owlhawk/modular-test-system/hardware/controllers/STM32_controller/daq_controller.pdf

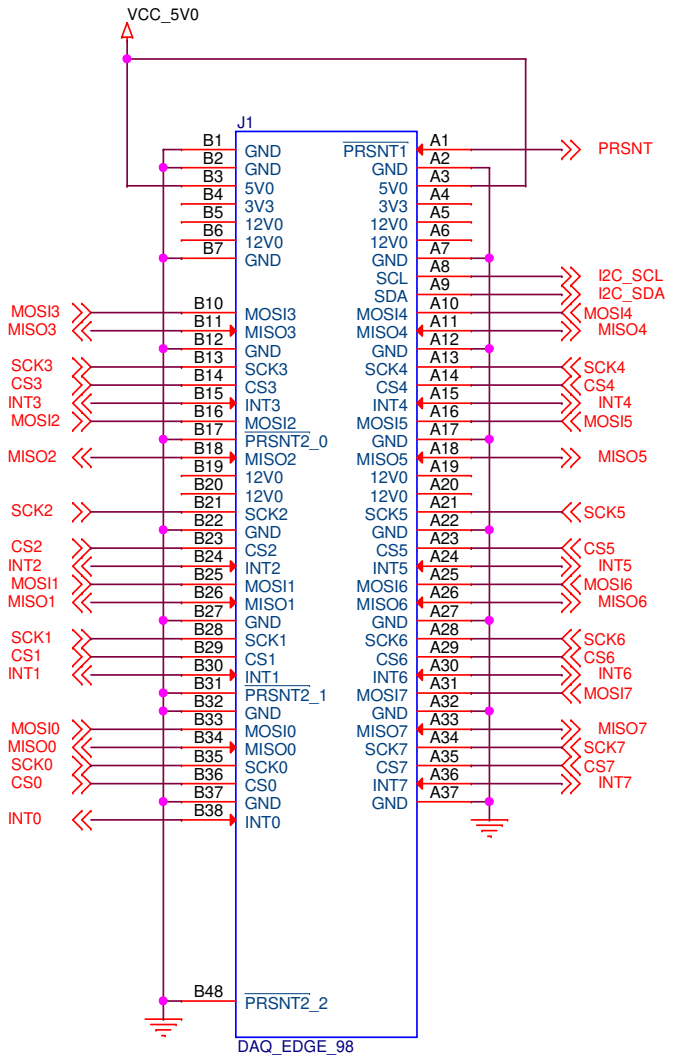
[picture p3: page 1]
VCC_5V0; MISO3; INT3; MISO2; MISO1; INT2; INT1; MISO0; INT0; MISO4; INT4; MISO5; INT5; MISO6; INT6; MISO7; INT7; MOSI3; MOSI4; SCK4 CS4; MOSI5; SCK5; MOSI6; SCK6 CS6; MOSI7; SCK7 CS7; SCK3 CS3; MOSI2; SCK2; MOSI1; SCK1 CS1; MOSI0; SCK0 CS0; PRSNT; I2C_SCL I2C_SDA; Title; Size; Document Number; Rev; Date:; Sheet; <Doc>; Card connector; Custom; Thursday, August 20, 2020; DAQ_EDGE_98; GND B1 GND B2 5V0 B3 3V3 B4 12V0 B5 12V0 B6 GND B7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

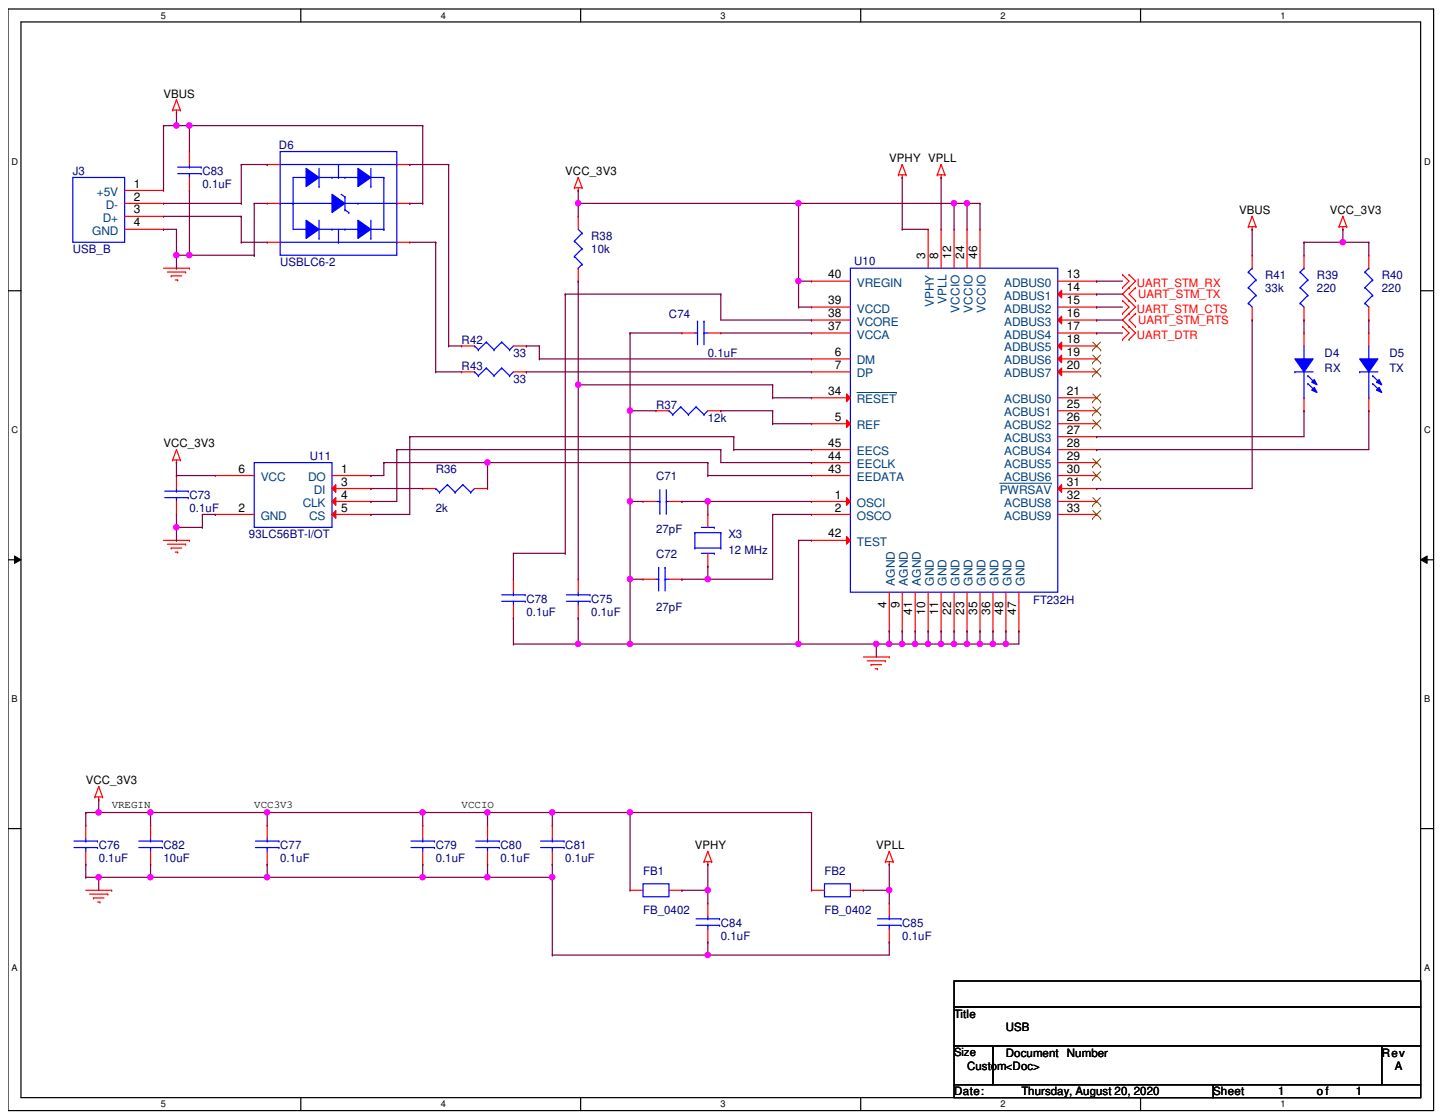
[picture p4: page 2]

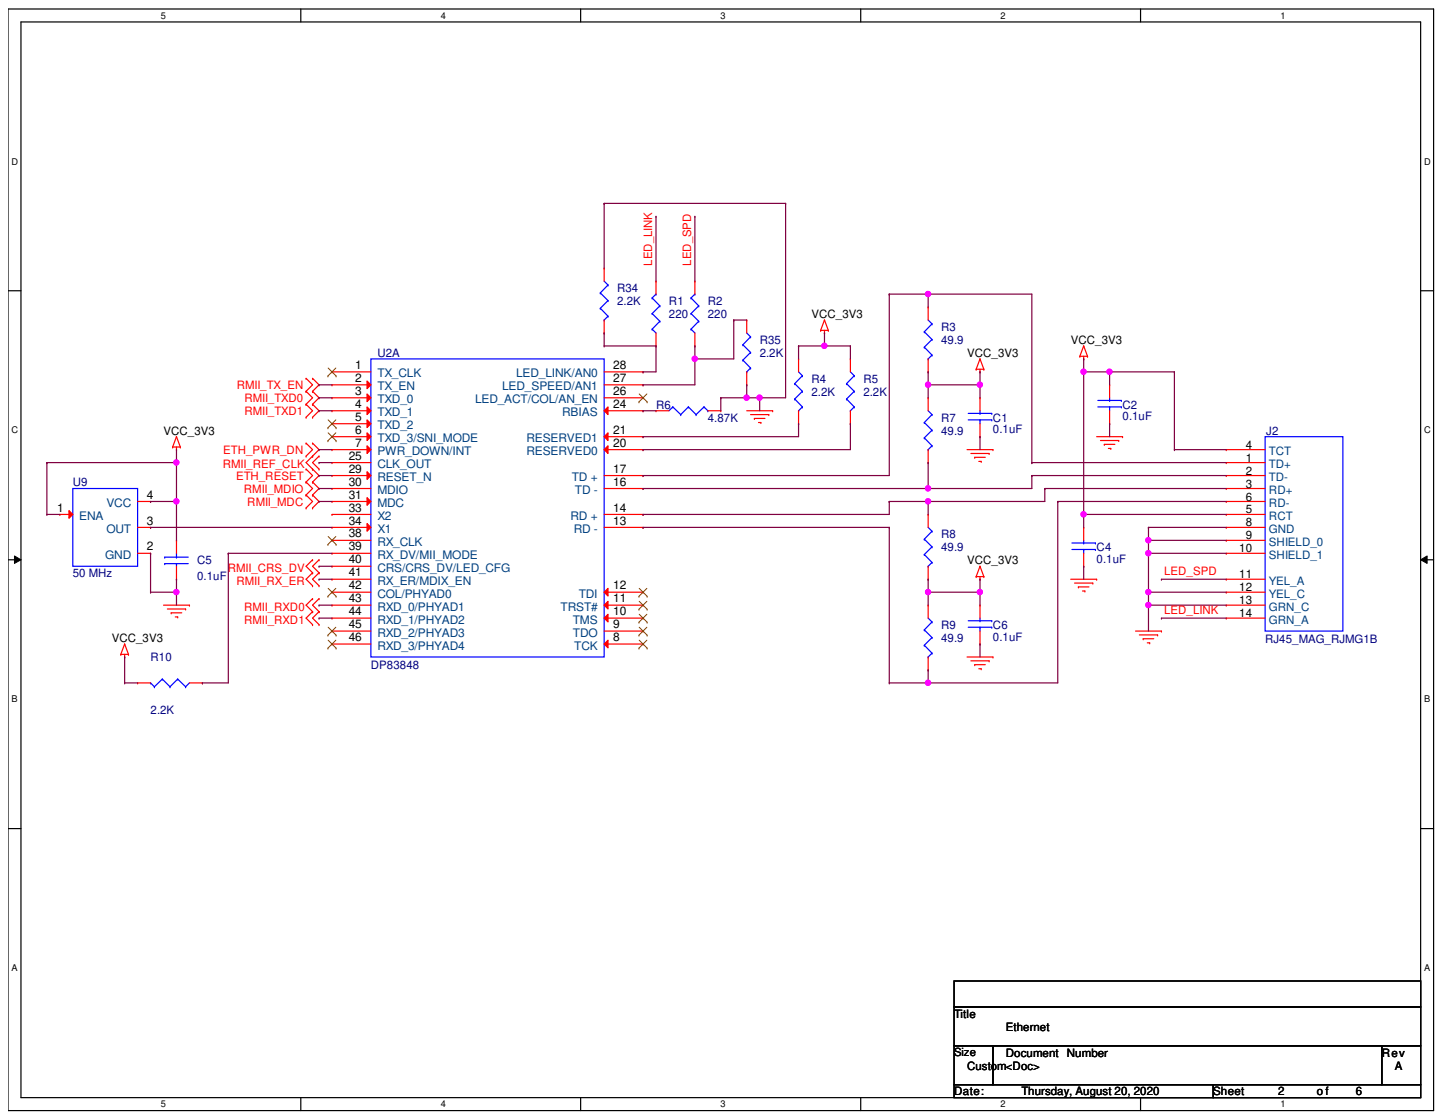
[picture p5: page 3]

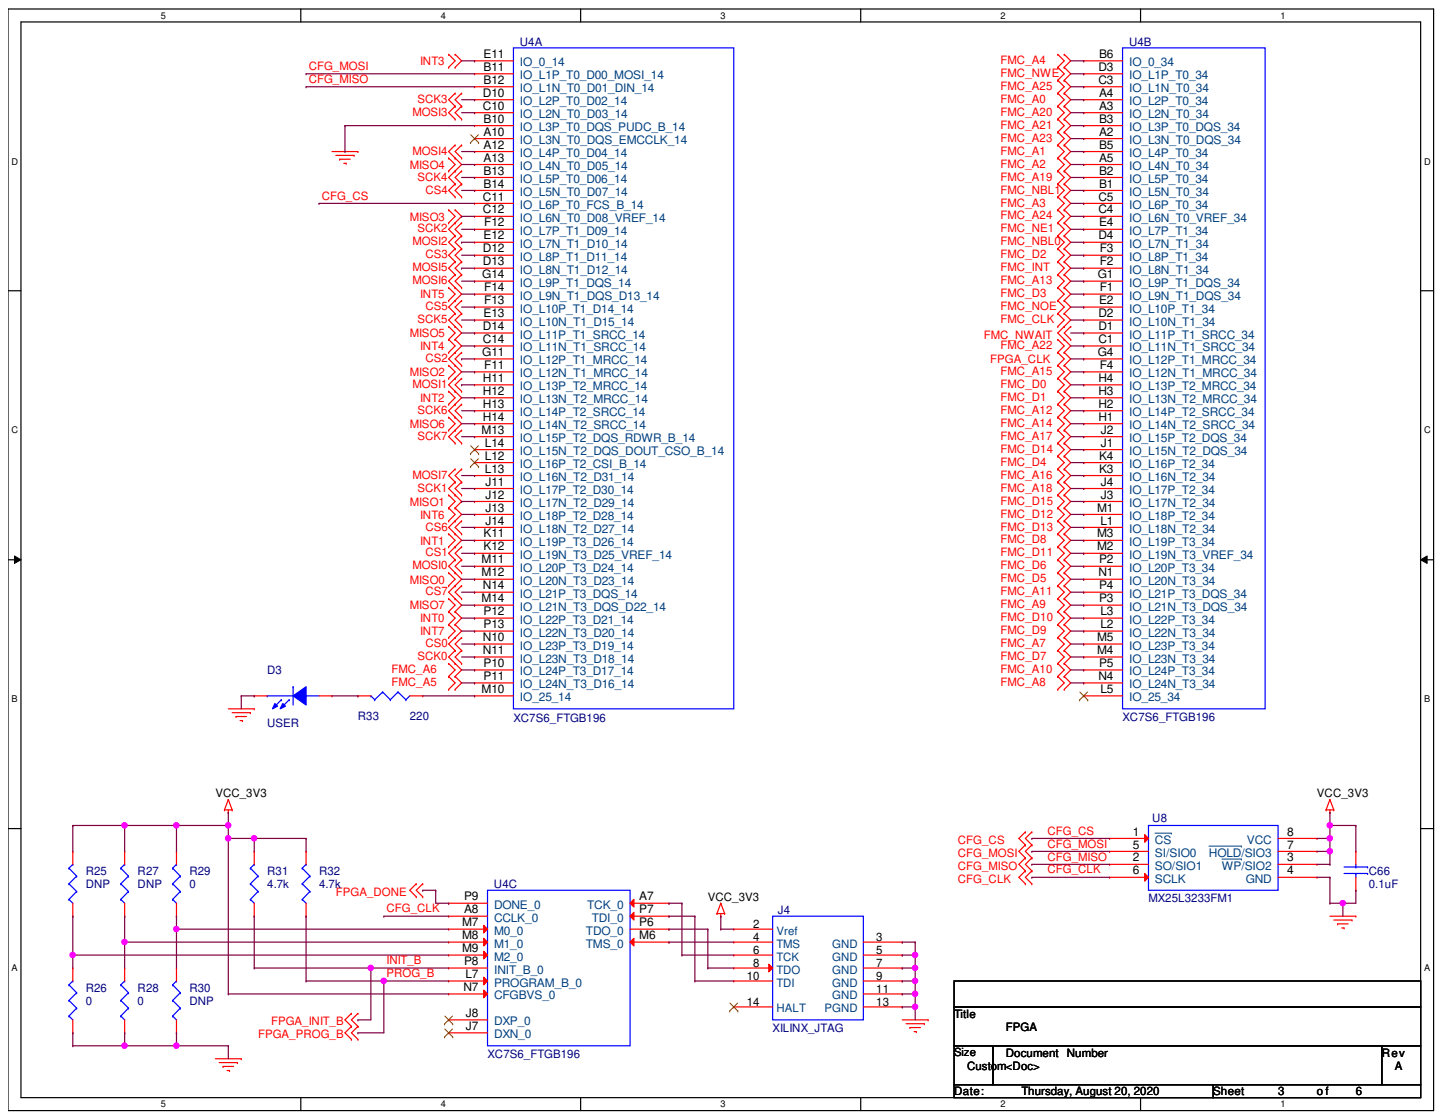
[picture p6: page 4]

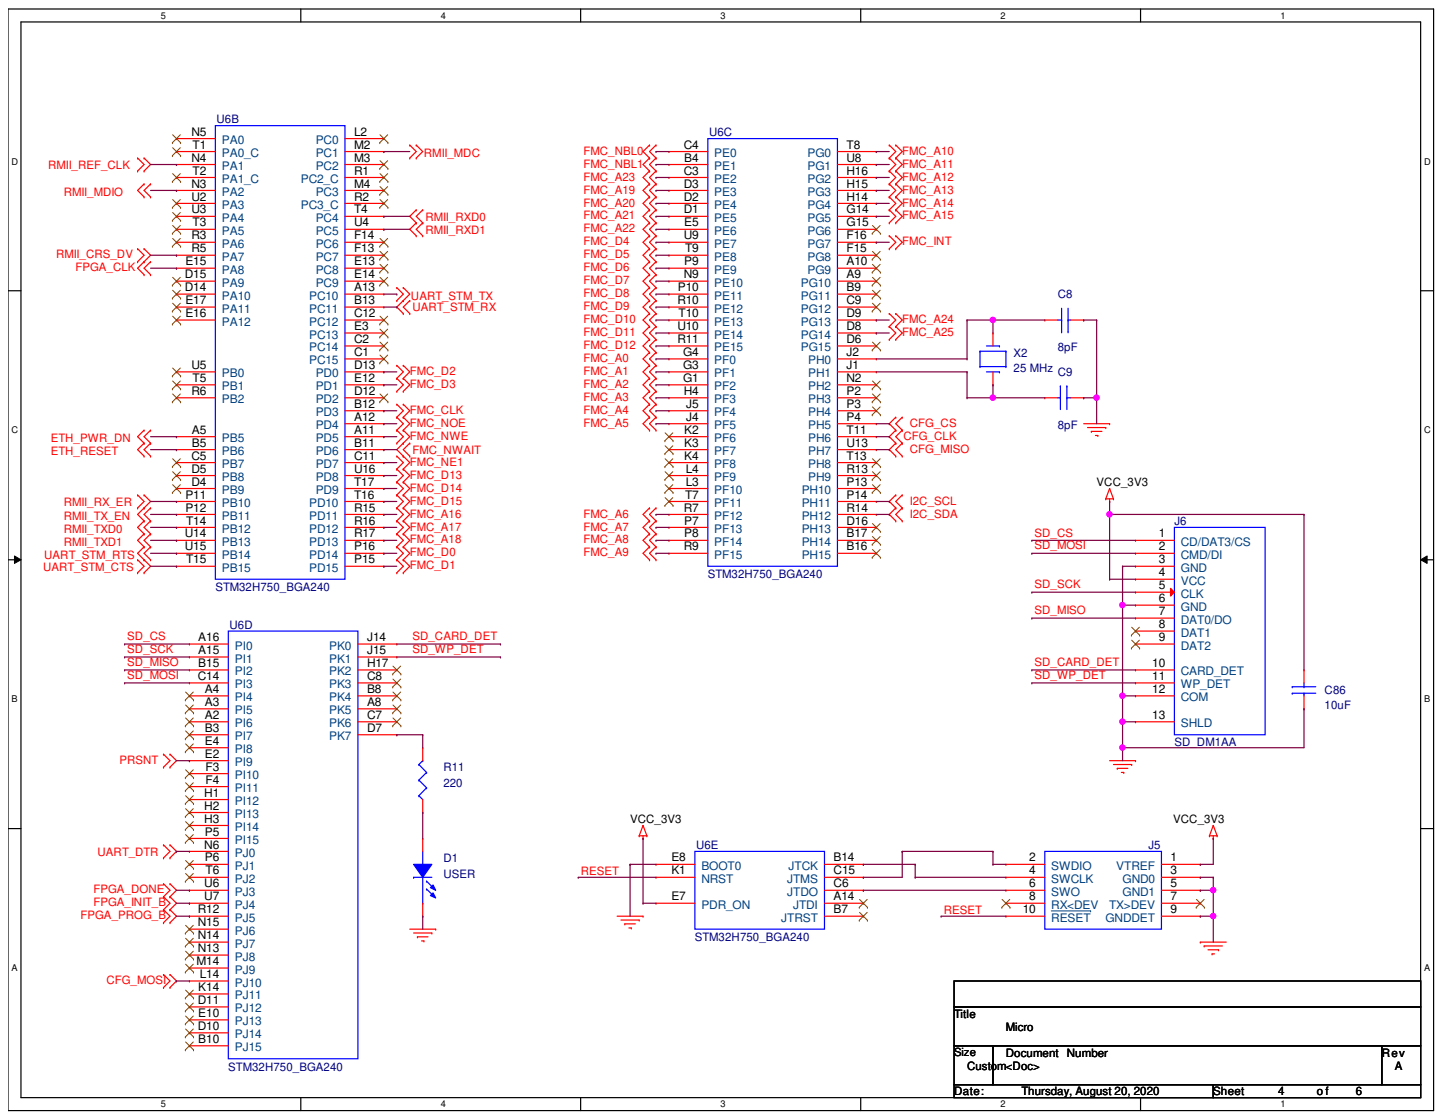
[picture p7: page 5]

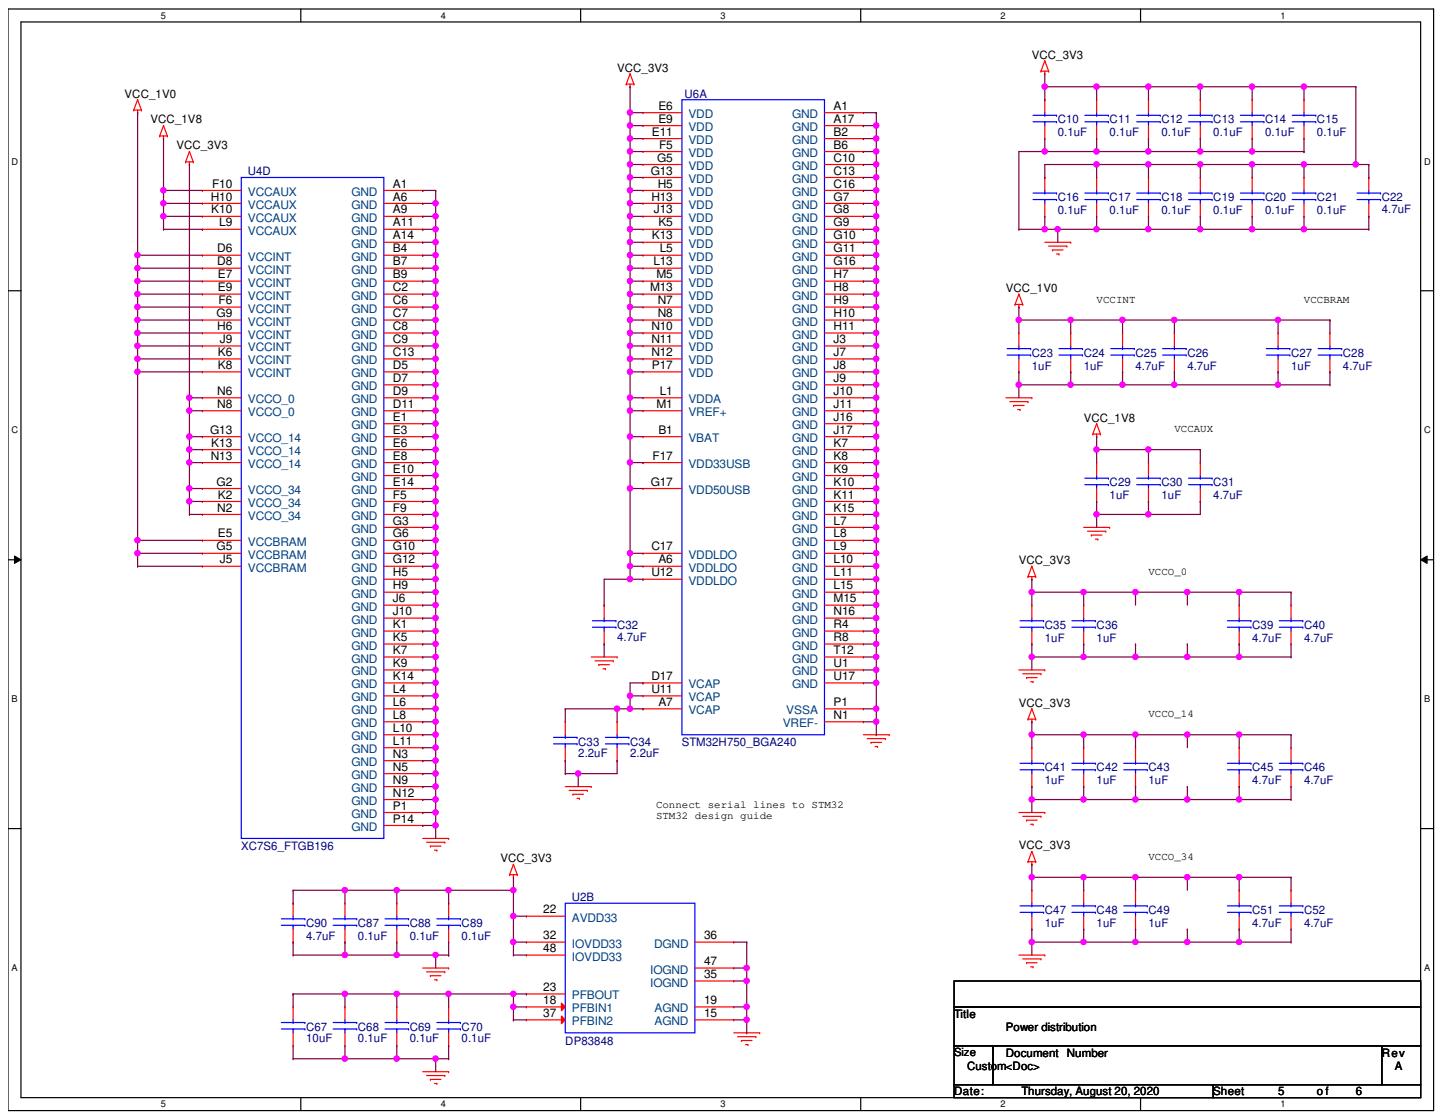
[picture p8: page 6]

Connect serial lines to STM32
STM32 design guide

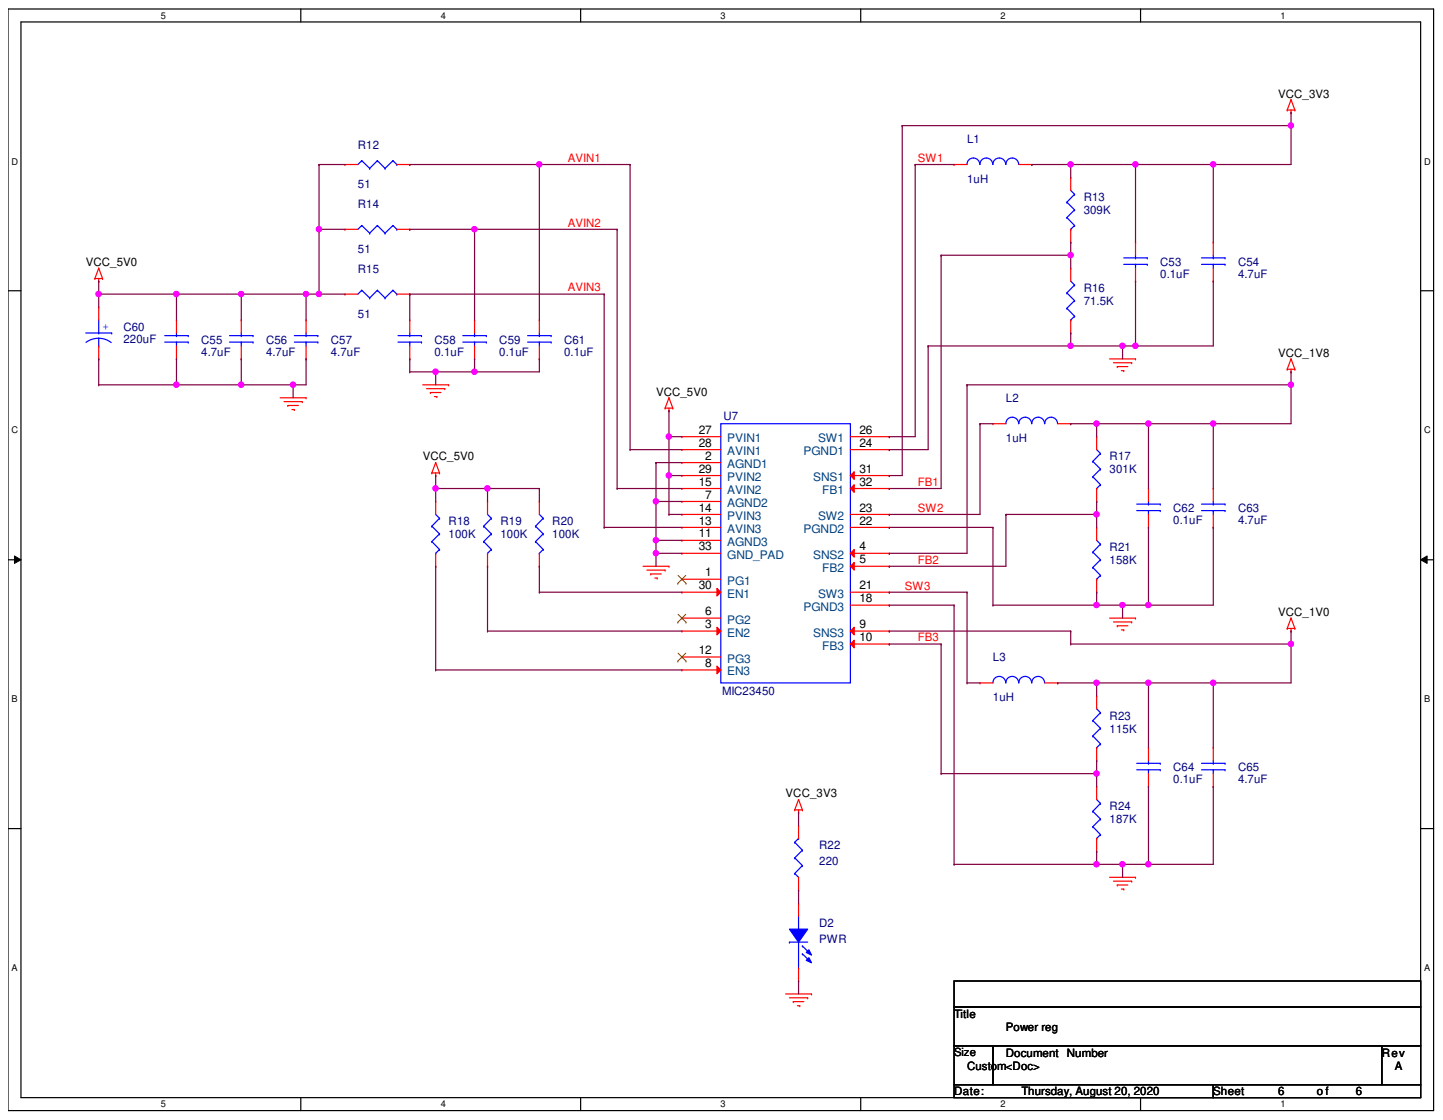
[picture p9: page 7]
