owlhawk/modular-test-system/hardware/cards/DIO_revB/dig_out_card.pdf

22 22 | 23 | 23 24 | 24 25 | 25 26 | 26 27 | 27 28 | 28 29 | 29 30 | 30 31 | 31 32 | 32 33 | 33 34 | 34 35 | 35 36 | 36 37 | 37 38 | 38 39 | 39 40 | 40 41 | 41 42 | 42 43 | 43 44 | 44

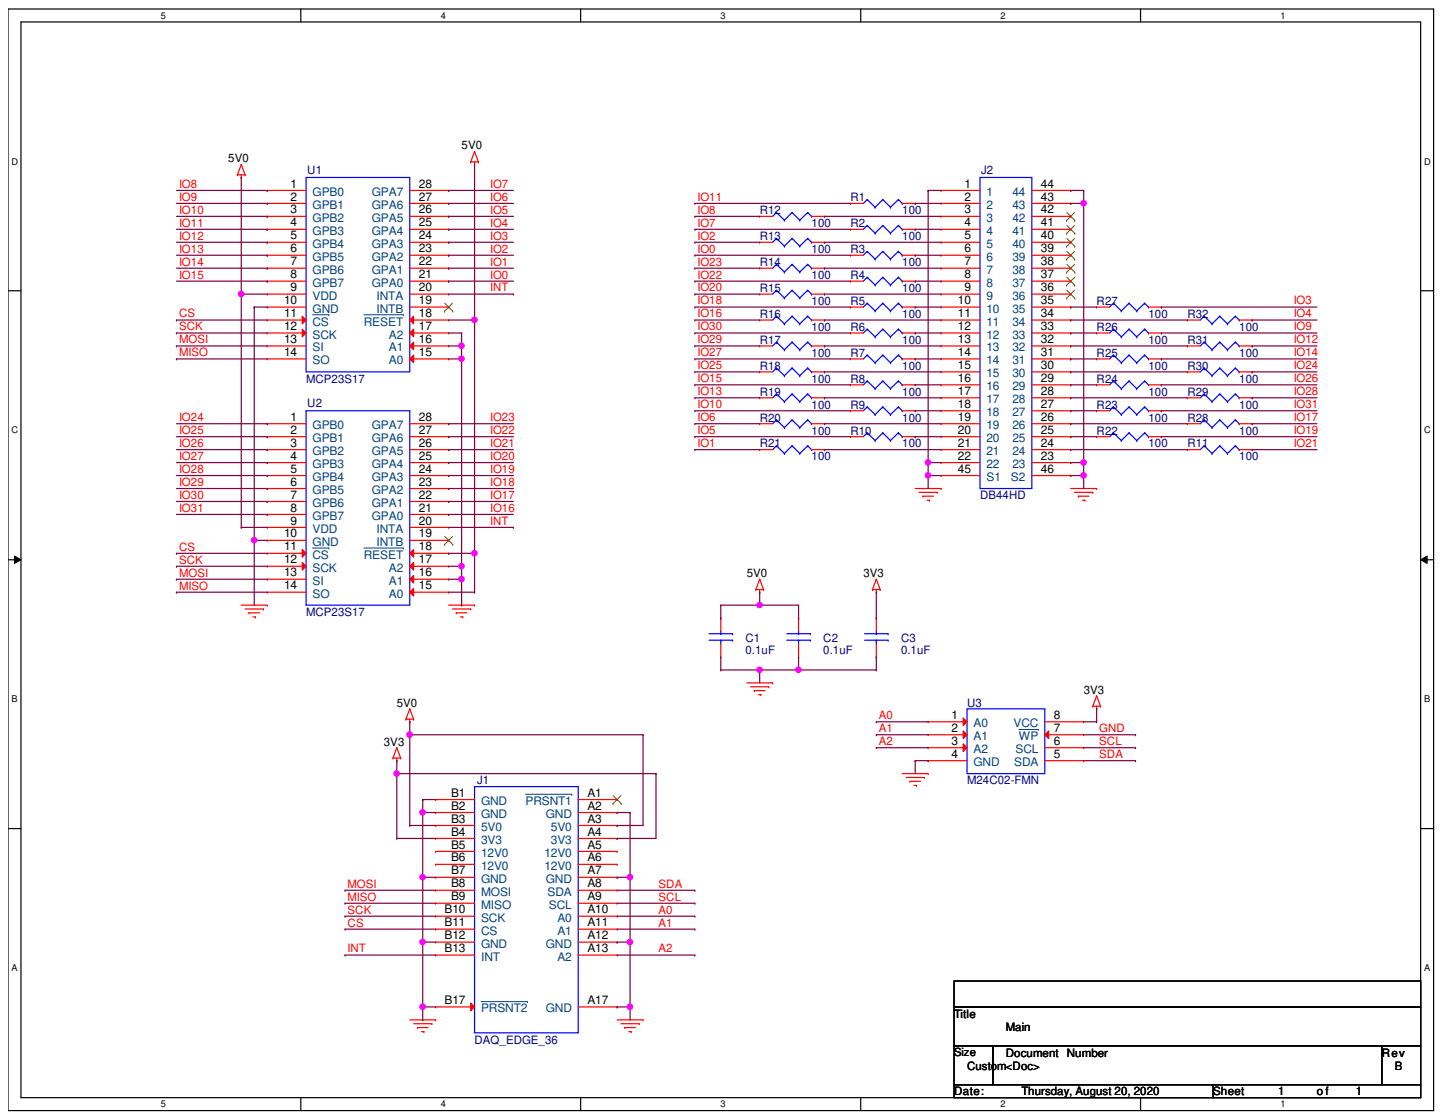
[picture p10: page 1]
