owlhawk/modular-test-system/hardware/chassis/7_slot_basic_chassis/daq_backplane.pdf

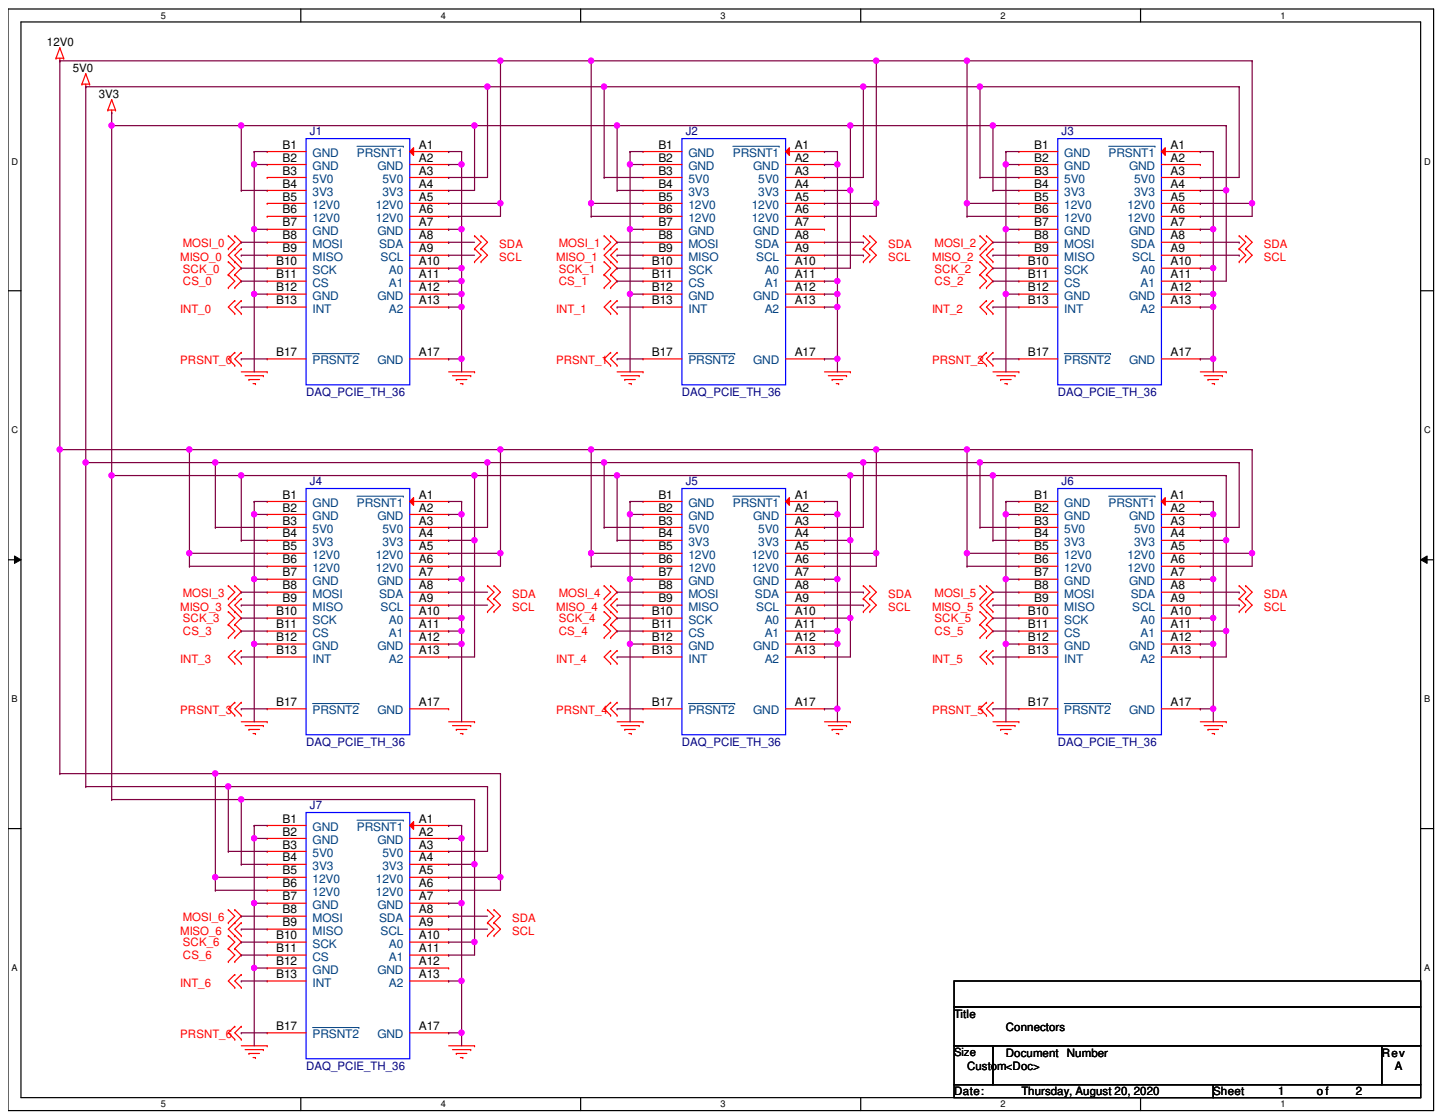
[picture p11: page 1]
MOSI_0 MISO_0 SCK_0 CS_0; INT_0; PRSNT_0; MOSI_1 MISO_1 SCK_1 CS_1; INT_1; PRSNT_1; MOSI_2 MISO_2 SCK_2 CS_2; INT_2; PRSNT_2; MOSI_6 MISO_6 SCK_6 CS_6; INT_6; PRSNT_6; MOSI_3 MISO_3 SCK_3 CS_3; INT_3; PRSNT_3; MOSI_4 MISO_4 SCK_4 CS_4; INT_4; PRSNT_4; MOSI_5 MISO_5 SCK_5 CS_5; INT_5; PRSNT_5; SCL; SDA; SDA SCL; Title; Size; Document Number; Rev; Date:; Sheet; <Doc>; Connectors; Custom; Thursday, August 20, 2020; DAQ_PCIE_TH_36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

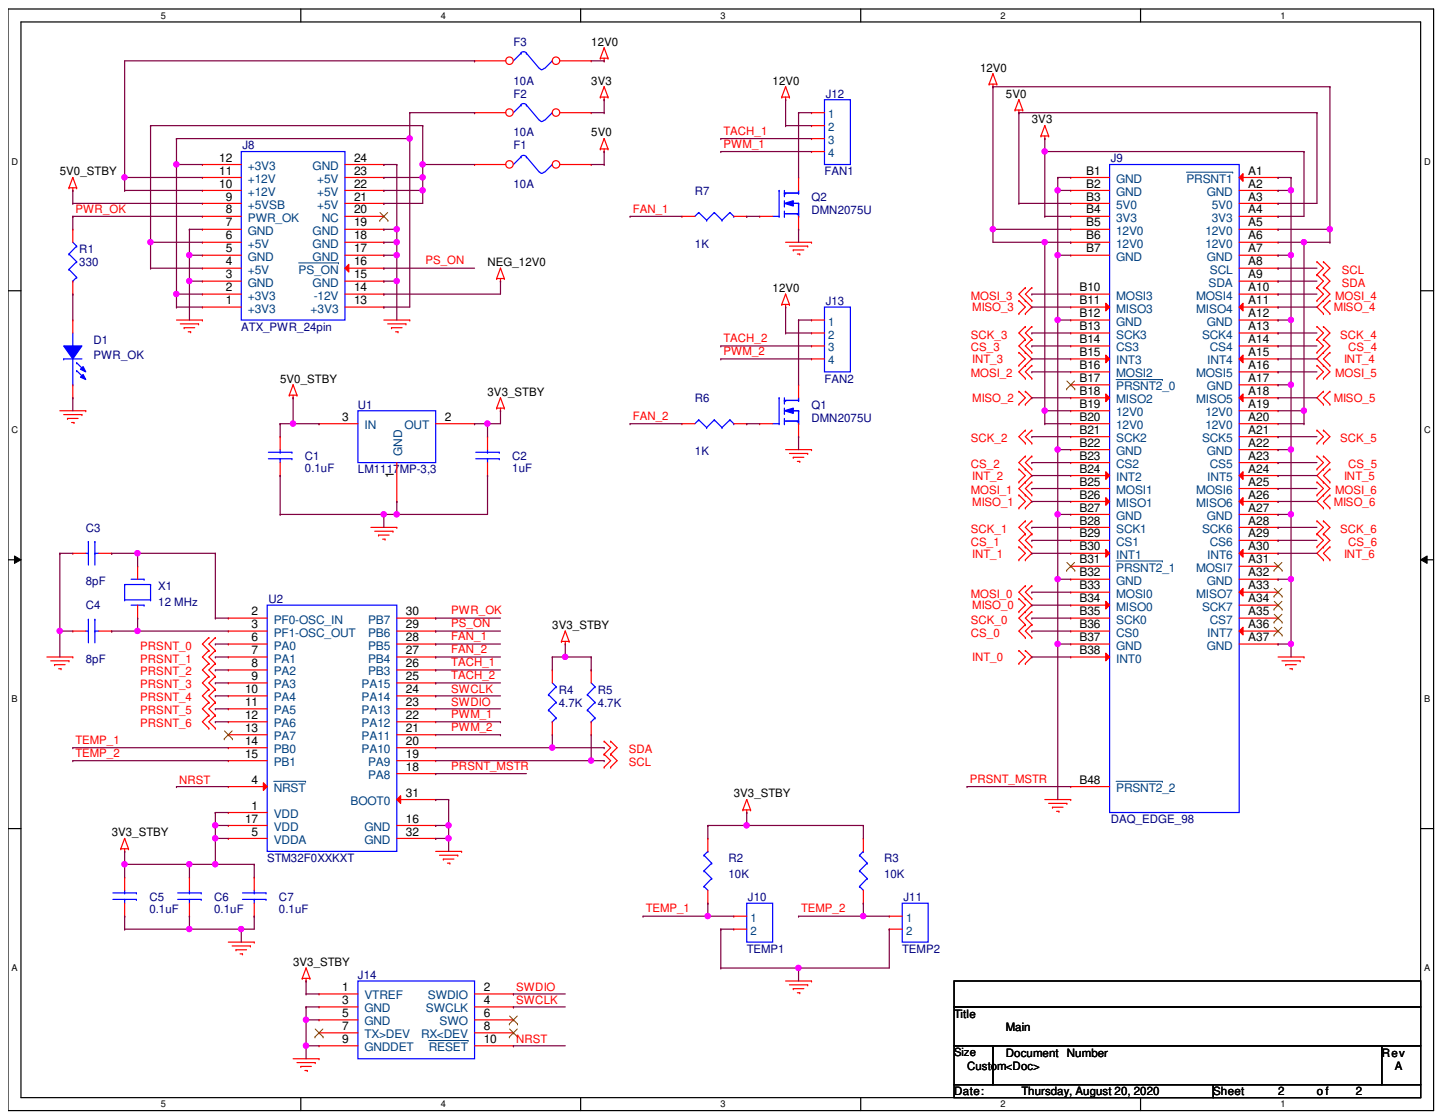
[picture p12: page 2]
