owlhawk/modular-test-system/(list of files, drawings)

Other design files:
hardware/cards/DIO_revB/DIG_OUT_CARD.DSN
hardware/cards/DIO_revB/Dig_out_card.opj
hardware/chassis/7_slot_basic_chassis/DAQ_BACKPLANE.DSN
hardware/chassis/7_slot_basic_chassis/DAQ_backplane.opj
hardware/controllers/STM32_controller/DAQ_CONTROLLER.DSN
hardware/controllers/STM32_controller/DAQ_controller.opj
